PerfectPatch/esp32-weather-station/images/enclosure_v2_inside.png

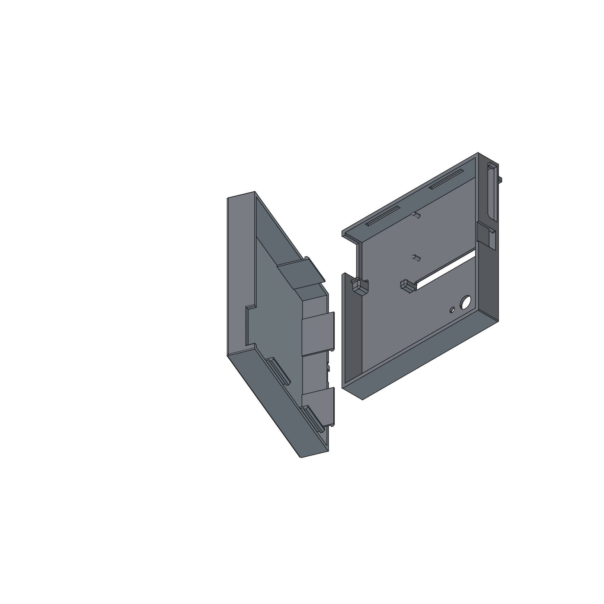
images/enclosure_v2_inside.png
