PerfectPatch/esp32-weather-station/images/enclosure_v2_outside.png

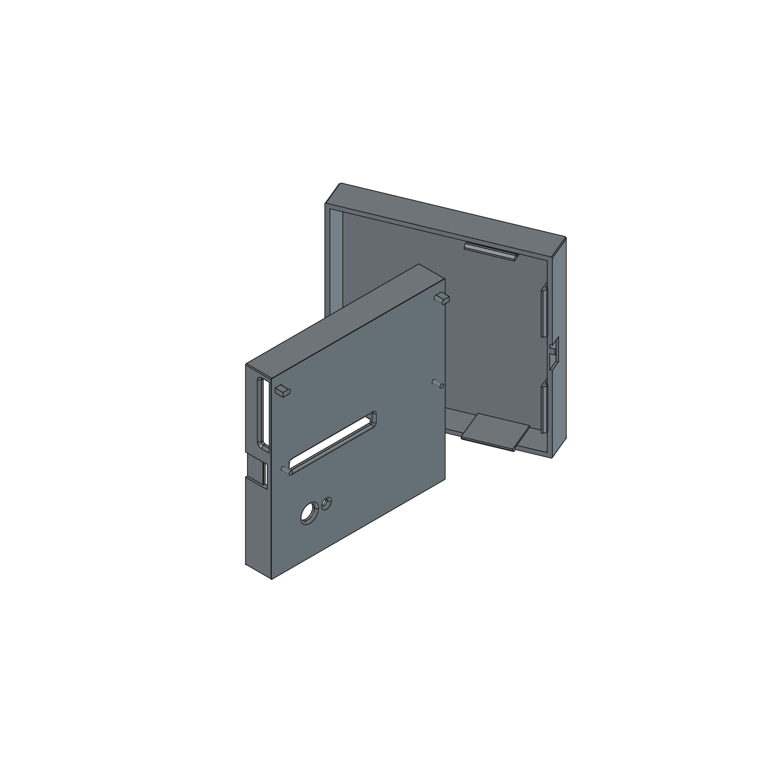
images/enclosure_v2_outside.png
