PerfectPatch/esp32-weather-station/hardware/enclosure/corpus_front.stl

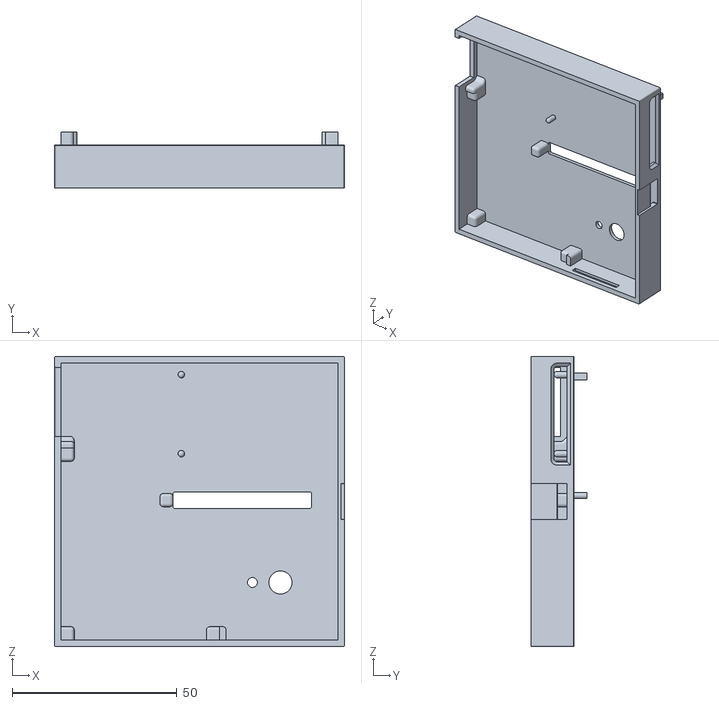
[picture p6: CAD file, 2026-10-17]
hardware/enclosure/corpus_front.stl
88.0 x 17.0 x 88.0
