PerfectPatch/esp32-weather-station/hardware/enclosure/corpus_back.stl

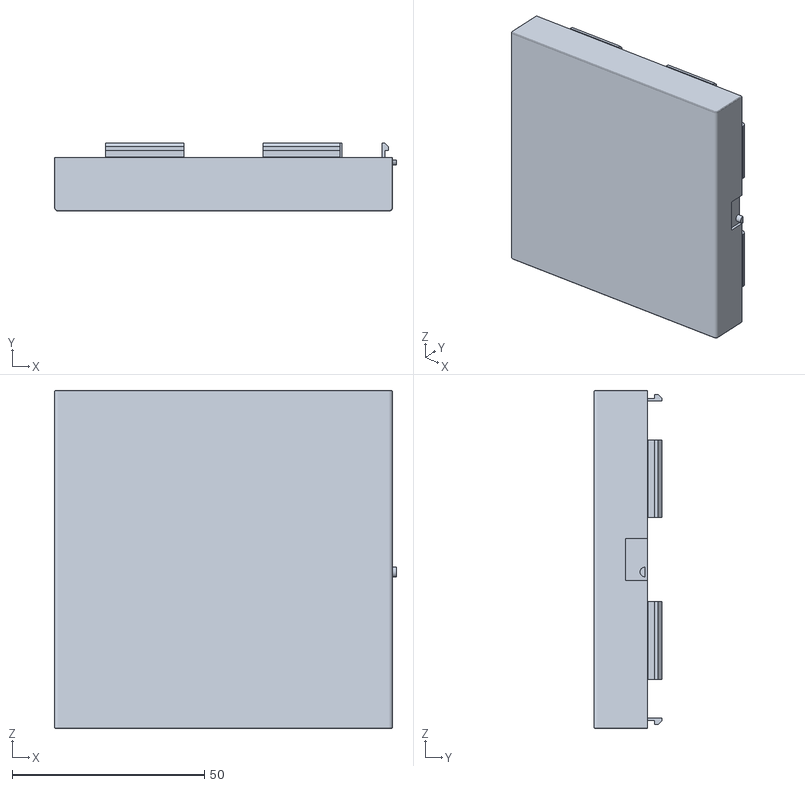
[picture p7: CAD file, 2026-10-17]
hardware/enclosure/corpus_back.stl
89.0 x 17.8 x 88.0
