PerfectPatch/esp32-weather-station/hardware/enclosure/weather-station-case.FCStd

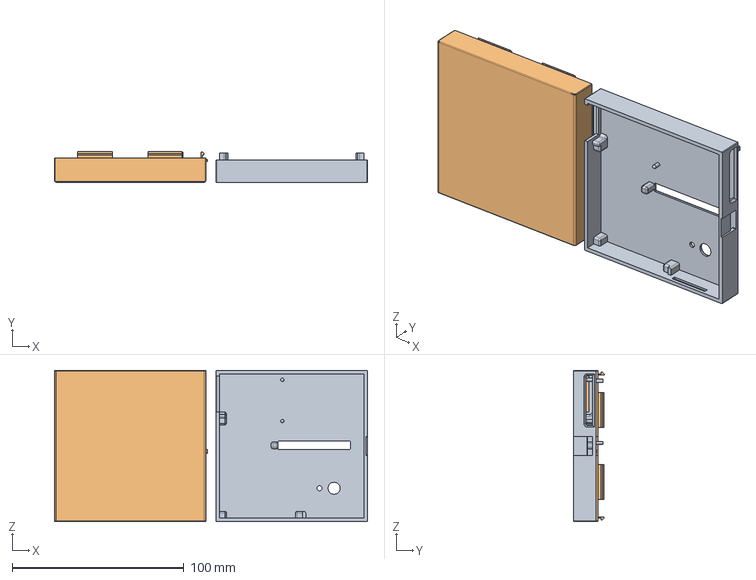
[picture p8: CAD file, 2026-10-17]
hardware/enclosure/weather-station-case.FCStd
182.0 x 17.8 x 88.0 mm
