PerfectPatch/esp32-weather-station/hardware/pcb/weather-station.pdf

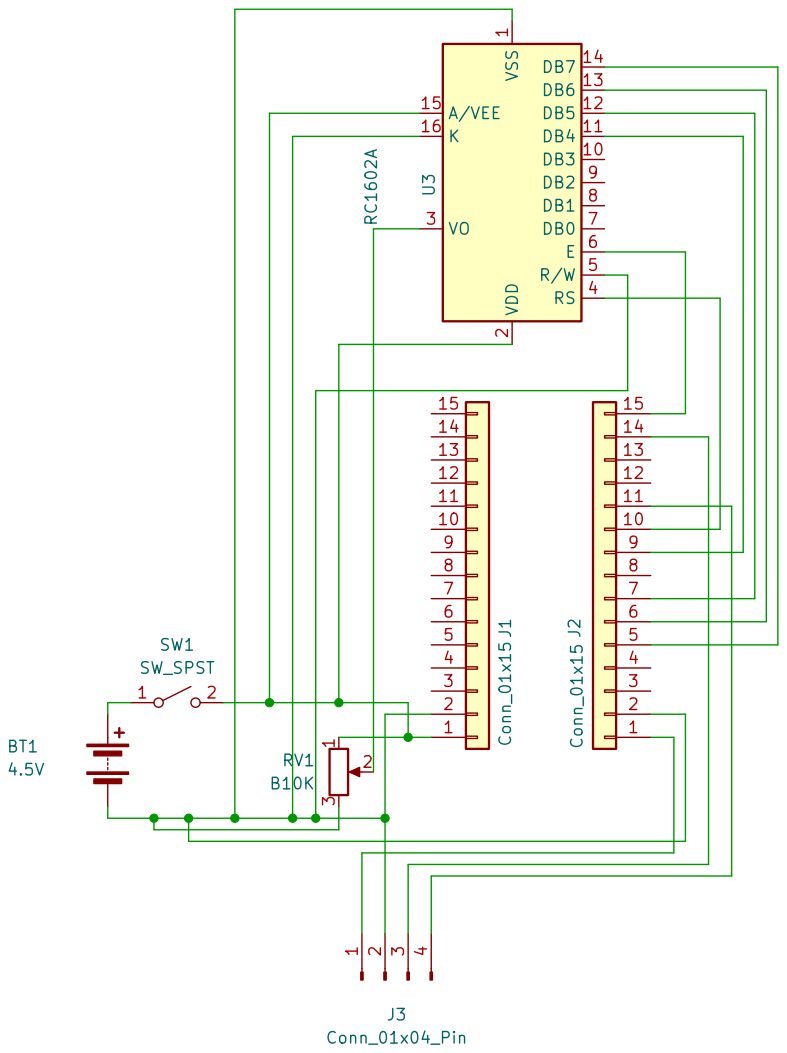
[picture p9: page 1]
