PerfectPatch/esp32-weather-station/hardware/pcb/weather-station.kicad_pcb

## KiCad design hardware/pcb/weather-station.kicad_pcb (2026-10-17)

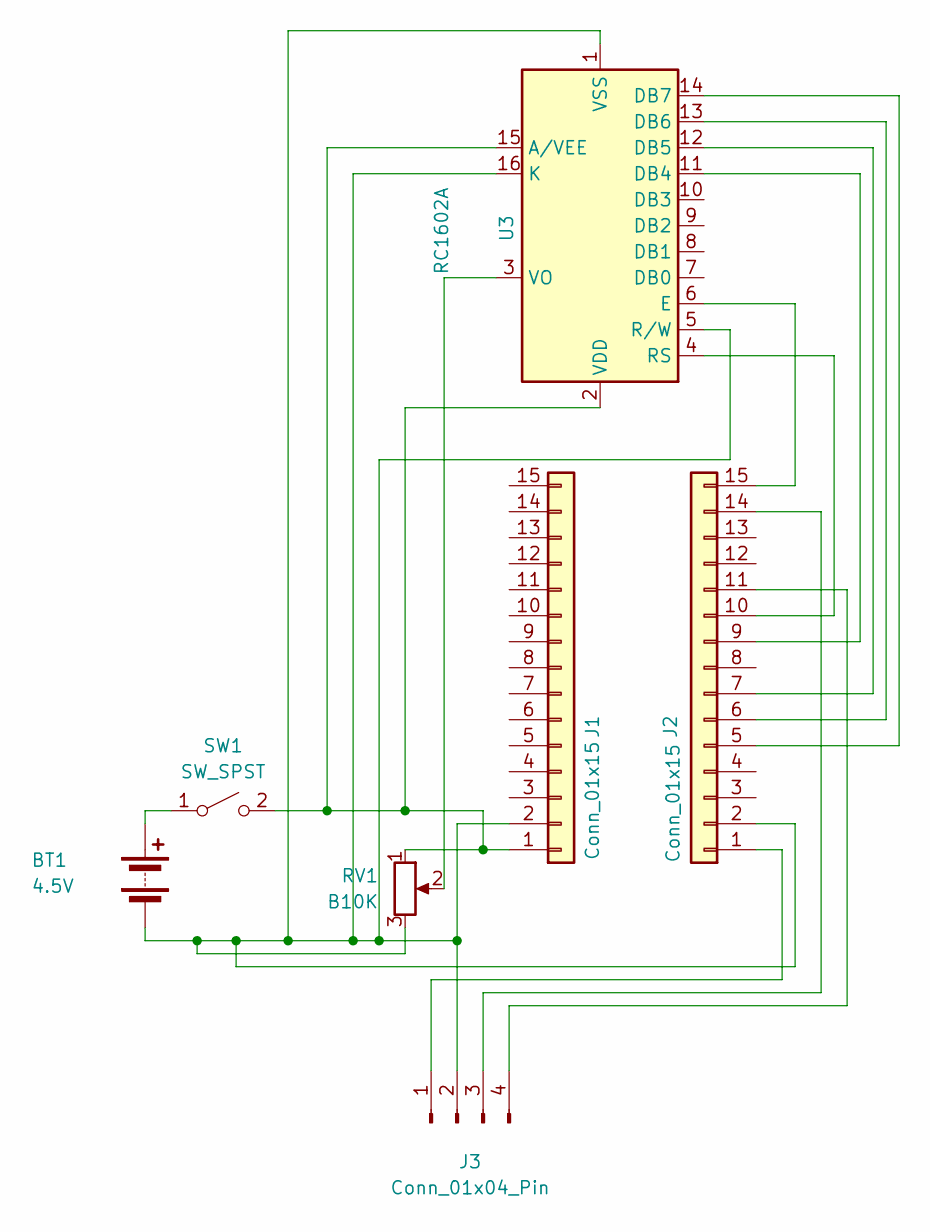
[picture p10: schematic weather-station.kicad_sch, ESP32 Weather Station – Carrier Board]

Parts:
BT1: 4.5V; BatteryHolder_Keystone_2479_3xAAA
J1, J2: Conn_01x15; PinHeader_1x15_P2.54mm_Vertical
J3: Conn_01x04_Pin; PinHeader_1x04_P2.54mm_Vertical
RV1: B10K; Potentiometer_Custom_3Pin
SW1: SW_SPST; PinHeader_1x02_P2.54mm_Vertical
U3: RC1602A

Connections:
unnamed: BT1.1 (+), SW1.1 (A)
unnamed: BT1.2 (-), J1.2, J2.2, J3.2, RV1.3, U3.1 (VSS), U3.5 (R/W), U3.16 (K)
unnamed: J1.1, RV1.1, SW1.2 (B), U3.2 (VDD), U3.15 (A/VEE)
unnamed: J2.1, J3.1
unnamed: J2.5, U3.14 (DB7)
unnamed: J2.6, U3.13 (DB6)
unnamed: J2.7, U3.12 (DB5)
unnamed: J2.9, U3.11 (DB4)
unnamed: J2.10, U3.4 (RS)
unnamed: J2.11, J3.4
unnamed: J2.14, J3.3
unnamed: J2.15, U3.6 (E)
unnamed: RV1.2, U3.3 (VO)

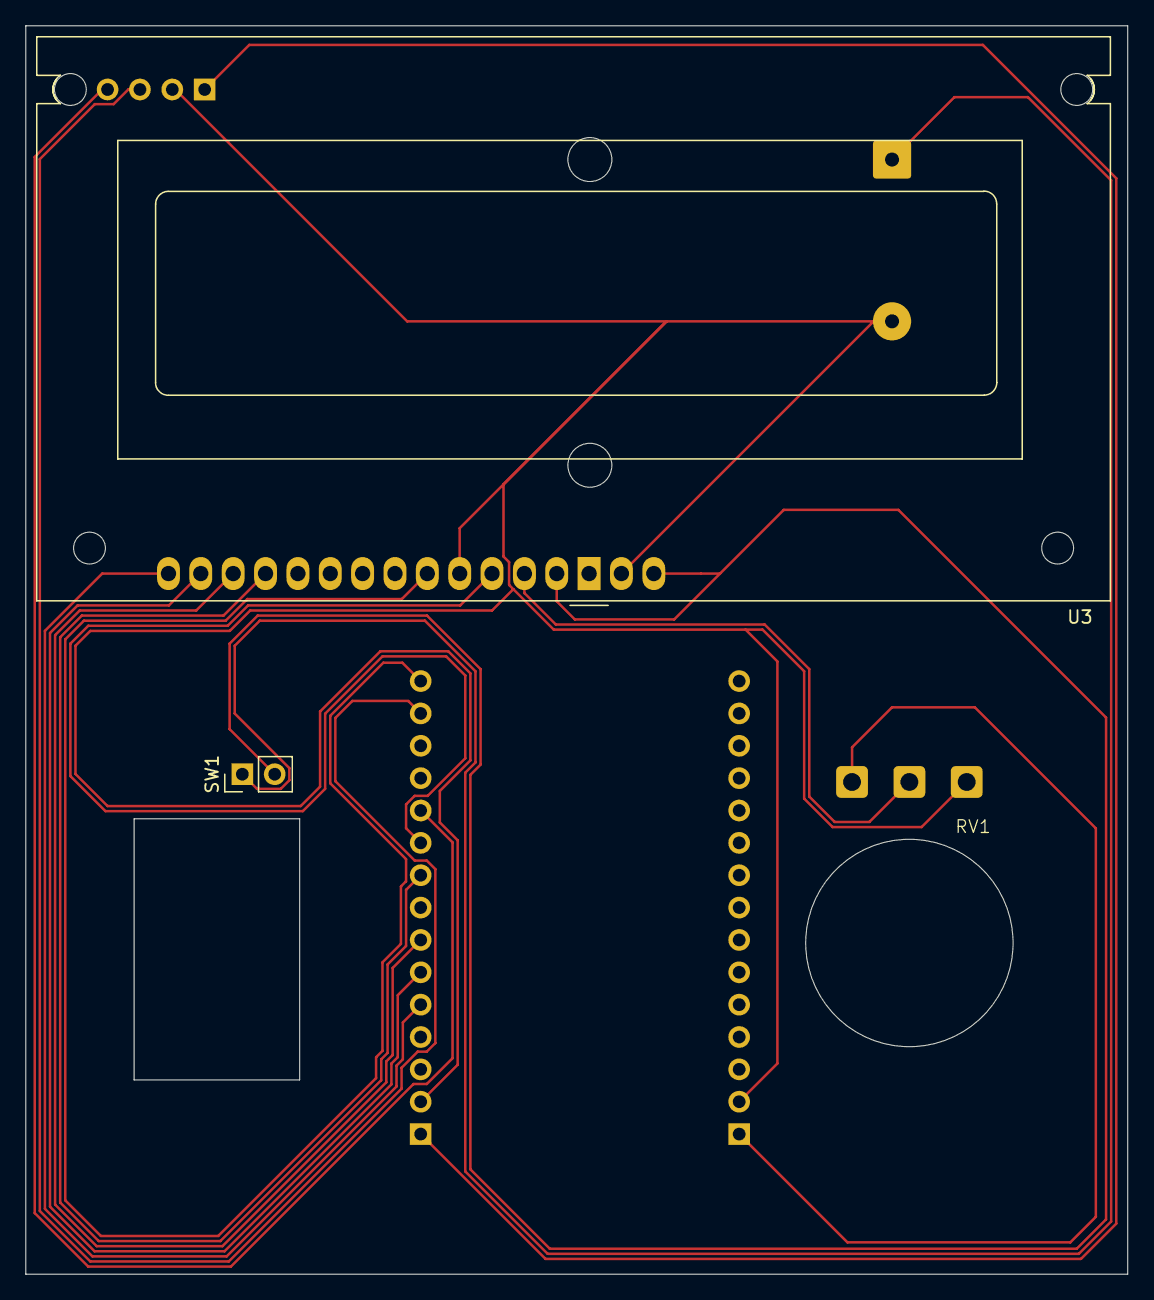
[picture p11: board weather-station.kicad_pcb from above]

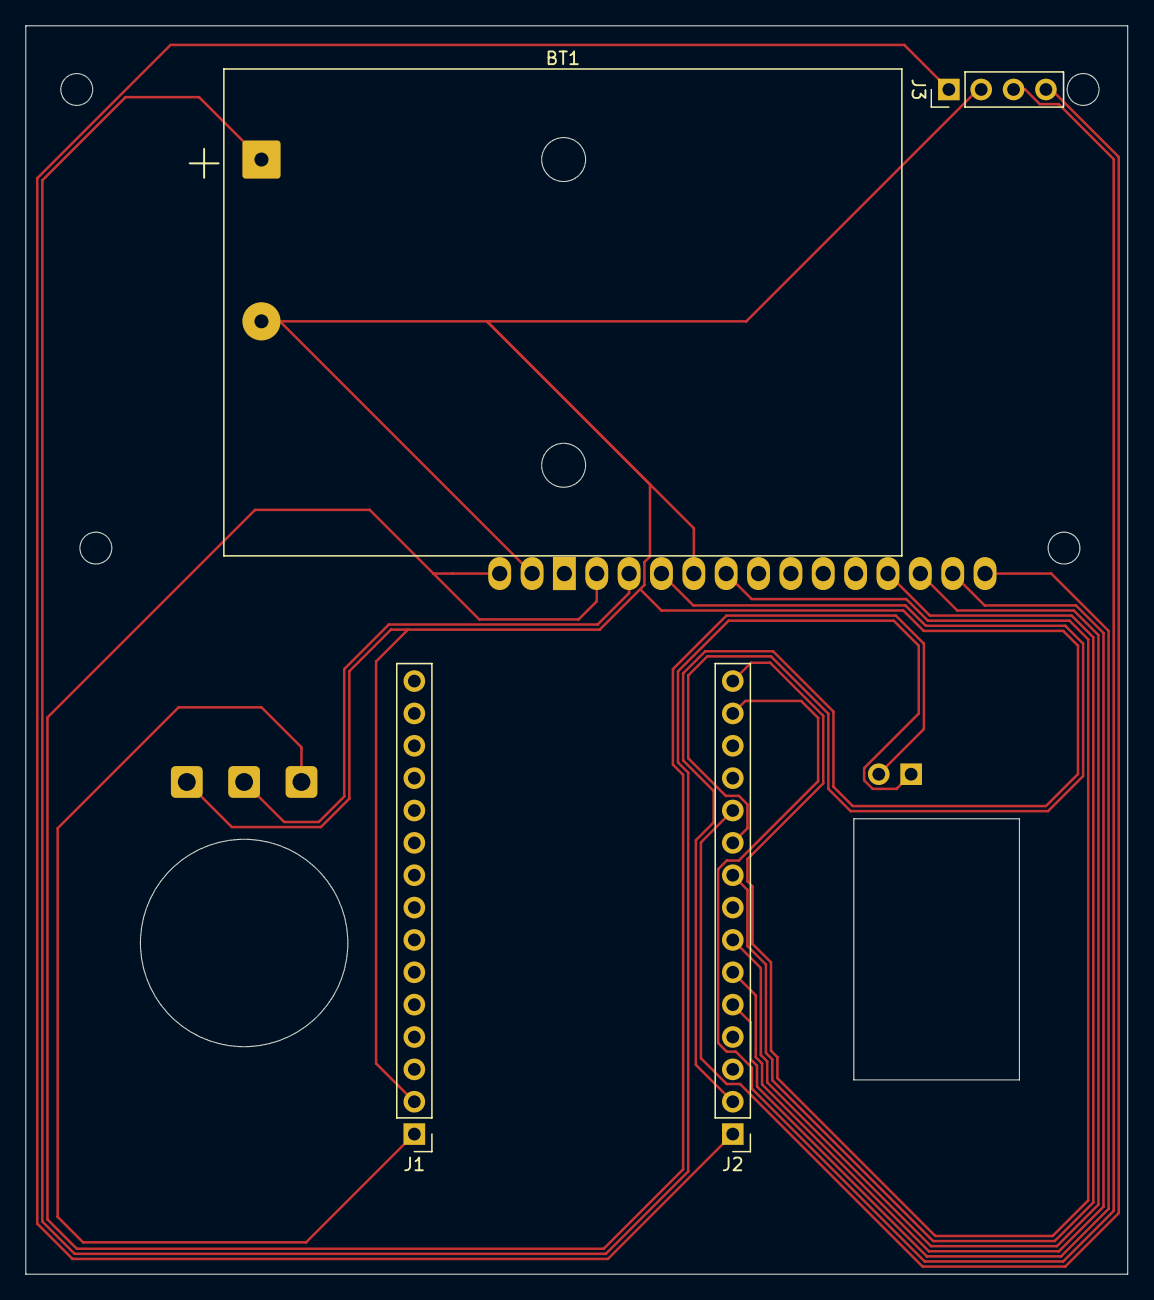
[picture p12: board weather-station.kicad_pcb from below]

Board: 2 copper layers, 86.5 x 98.0 mm, 7 parts (4 on the bottom side), 13 nets.
