PerfectPatch/esp32-weather-station/(commit log)

2026-10-14 Enhance README with detailed project information
    Expanded project description, added features, hardware details, wiring instructions, enclosure design, PCB progress, firmware building steps, repository structure, and next steps.
2026-10-17 Add carrier PCB (v3), schematic, renders and enclosure files
    [corpus_back.stl, corpus_front.stl, weather-station-case.FCStd, weather-station.kicad_pcb, weather-station.kicad_sch]
